Nerradia/SLABoard/BOM_excel.xlsx

Généré par KiCad |  |  | RS |  |  | Farnell
Valeur | Nombre | Références | Prix TTC pièce | Quantité par paquet | Référence RS | Prix TTC pièce | Quantité par paquet | Référence RS | Quantité à commander | Prix commande
100n | 2 | C19 C21 | 0.0348 | 125 | 264-4191 |  |  |  | 125 | 4.35 | ,
220n | 20 | C1 C2 C3 C7 C8 C9 C10 C11 C12 C13 C14 C15 C16 C22 C23 C24 C25 C26 C27 C28 | 0.0492 | 25 | 1886344 |  |  |  | 25 | 1.23 | ,
10u | 4 | C5 C6 C18 C20 | 0.416 | 10 | 7900613 |  |  |  | 10 | 4.16 | ,
220u | 2 | C4 C17 | 0.0804 | 50 | 7111097 |  |  |  | 50 | 4.02 | ,
DIODE | 2 | D1 D2 |  |  |  |  |  |  | 0 | 0
INDUCTOR | 4 | L1 L2 L3 L4 | 0.323 | 10 | 786-7175 |  |  |  | 10 | 3.23 | ,
FDS6898A | 2 | Q1 Q2 | 0.994 | 5 | 8648701 |  |  |  | 5 | 4.97 | ,
DMG3420U | 3 | Q3 Q4 Q5 | 0.0516 | 50 | 7514092 |  |  |  | 50 | 2.58 | ,
100 | 1 | R2 | 0.0108 | 50 | 2232120 |  |  |  | 50 | 0.54 | ,
374 | 4 | R6 R7 R8 R9 | 0.84 | 5 | 828-0976 |  |  |  | 5 | 4.2 | ,
750 | 4 | R11 R12 R13 R14 | 0.226 | 5 | 6696540 |  |  |  | 5 | 1.13 | ,
1,3k | 4 | Val alternative pour R11 R12 R13 R14 | 0.23 | 5 | 8280885 |  |  |  | 5 | 1.15 | ,
1k | 5 | R15 R16 R18 R20 R22 | 0.0096 | 100 | 9013724 |  |  |  | 100 | 0.96
10k | 9 | R1 R3 R4 R5 R10 R24 R25 R26 R32 | 0.0096 | 100 | 9013733 |  |  |  | 100 | 0.96
SPEAKER | 1 | SP1 |  |  |  |  |  |  | 0 | 0
TEENSY3.6 | 1 | U1 |  |  |  |  |  |  | 0 | 0
LM5106 | 2 | U2 U3 | 1.756 | 5 | 651-2789 | 1.848 | 1 | 1312793 | 3 | 5.544 | ,
AD1852 | 1 | U6 | 15.47 | 1 | 709-5614 |  |  |  | 1 | 15.47 | ,
TMC2100 | 1 | U7 |  |  |  |  |  |  | 0 | 0
OPA1632 | 2 | U8 U9 | 6.48 | 1 | 619-9875 |  |  |  | 2 | 12.96 | ,
 | 1 | Lunettes de sécurité |  |  |  | 7.2 | 1 | 1555620 | 1 | 7.2 | ,
 | 1 | Lunettes UV | 13.55 | 1 | 7258102 |  |  |  | 1 | 13.55 | ,
 | 1 | Alcool Isopropylique 1L |  |  |  | 21.024 | 1 | 106970 | 1 | 21.024 | ,
2.2n | 4 | C1 C2 C12 C13 | 0.018 | 100 | 8392940 |  |  |  | 100 | 1.8 | ,
22n | 1 | C4 | 0.0084 | 100 | 7980329 |  |  |  | 100 | 0.84 | ,
100n | 4 | C7 C8 C9 C10 | 0.0084 | 100 | 6983320 |  |  |  | 100 | 0.84 | ,
2.2u | 3 | C3 C5 C6 | 0.0936 | 50 | 8151358 |  |  |  | 50 | 4.68 | ,
4.7u | 4 | C11 C14 C15 C16 | 0.12 | 20 | 9159173 |  |  |  | 20 | 2.4 | ,
CAPAPOL | 3 | C17 C18 C19 | 0.15 | 10 | 756-7825 |  |  |  | 10 | 1.5 | ,
NTMFS1935N | 6 | Q1 Q2 Q3 Q4 Q5 Q6 | 0.455 | 10 | 7804711 |  |  |  | 20 | 9.1 | ,
20m | 2 | R13 R9 | 0.384 | 5 | 566569 |  |  |  | 5 | 1.92 | ,
5.1 | 6 | R6 R7 R10 R11 R14 R15 | 0.031 | 10 | 794-4092 |  |  |  | 10 | 0.31 | ,
56 | 4 | R3 R4 R8 R12 | 0.018 | 50 | 679-0550 |  |  |  | 50 | 0.9 | ,
10k | 2 | R1 R2 | 0.0204 | 50 | 7408805 |  |  |  | 50 | 1.02 | ,
18k | 1 | R5 | 0.024 | 50 | 6789857 |  |  |  | 50 | 1.2 | ,
DRV8301 | 1 | U1 | 6.6 | 1 | 8136466 | 7.92 | 1 | 2057084 | 1 | 7.92 | ,
 |  |  |  |  |  |  |  |  | Total Farnell | 41.688
 |  |  |  |  |  |  |  |  | Total RS | 101.97
 |  |  |  |  |  |  |  |  |  | 143.658
 |  |  |  |  |  |  |  |  | Total | 143.658
