Nerradia/SLABoard/projetcarteslav1.kicad_pcb

## KiCad design projetcarteslav1.kicad_pcb (2017-08-12)

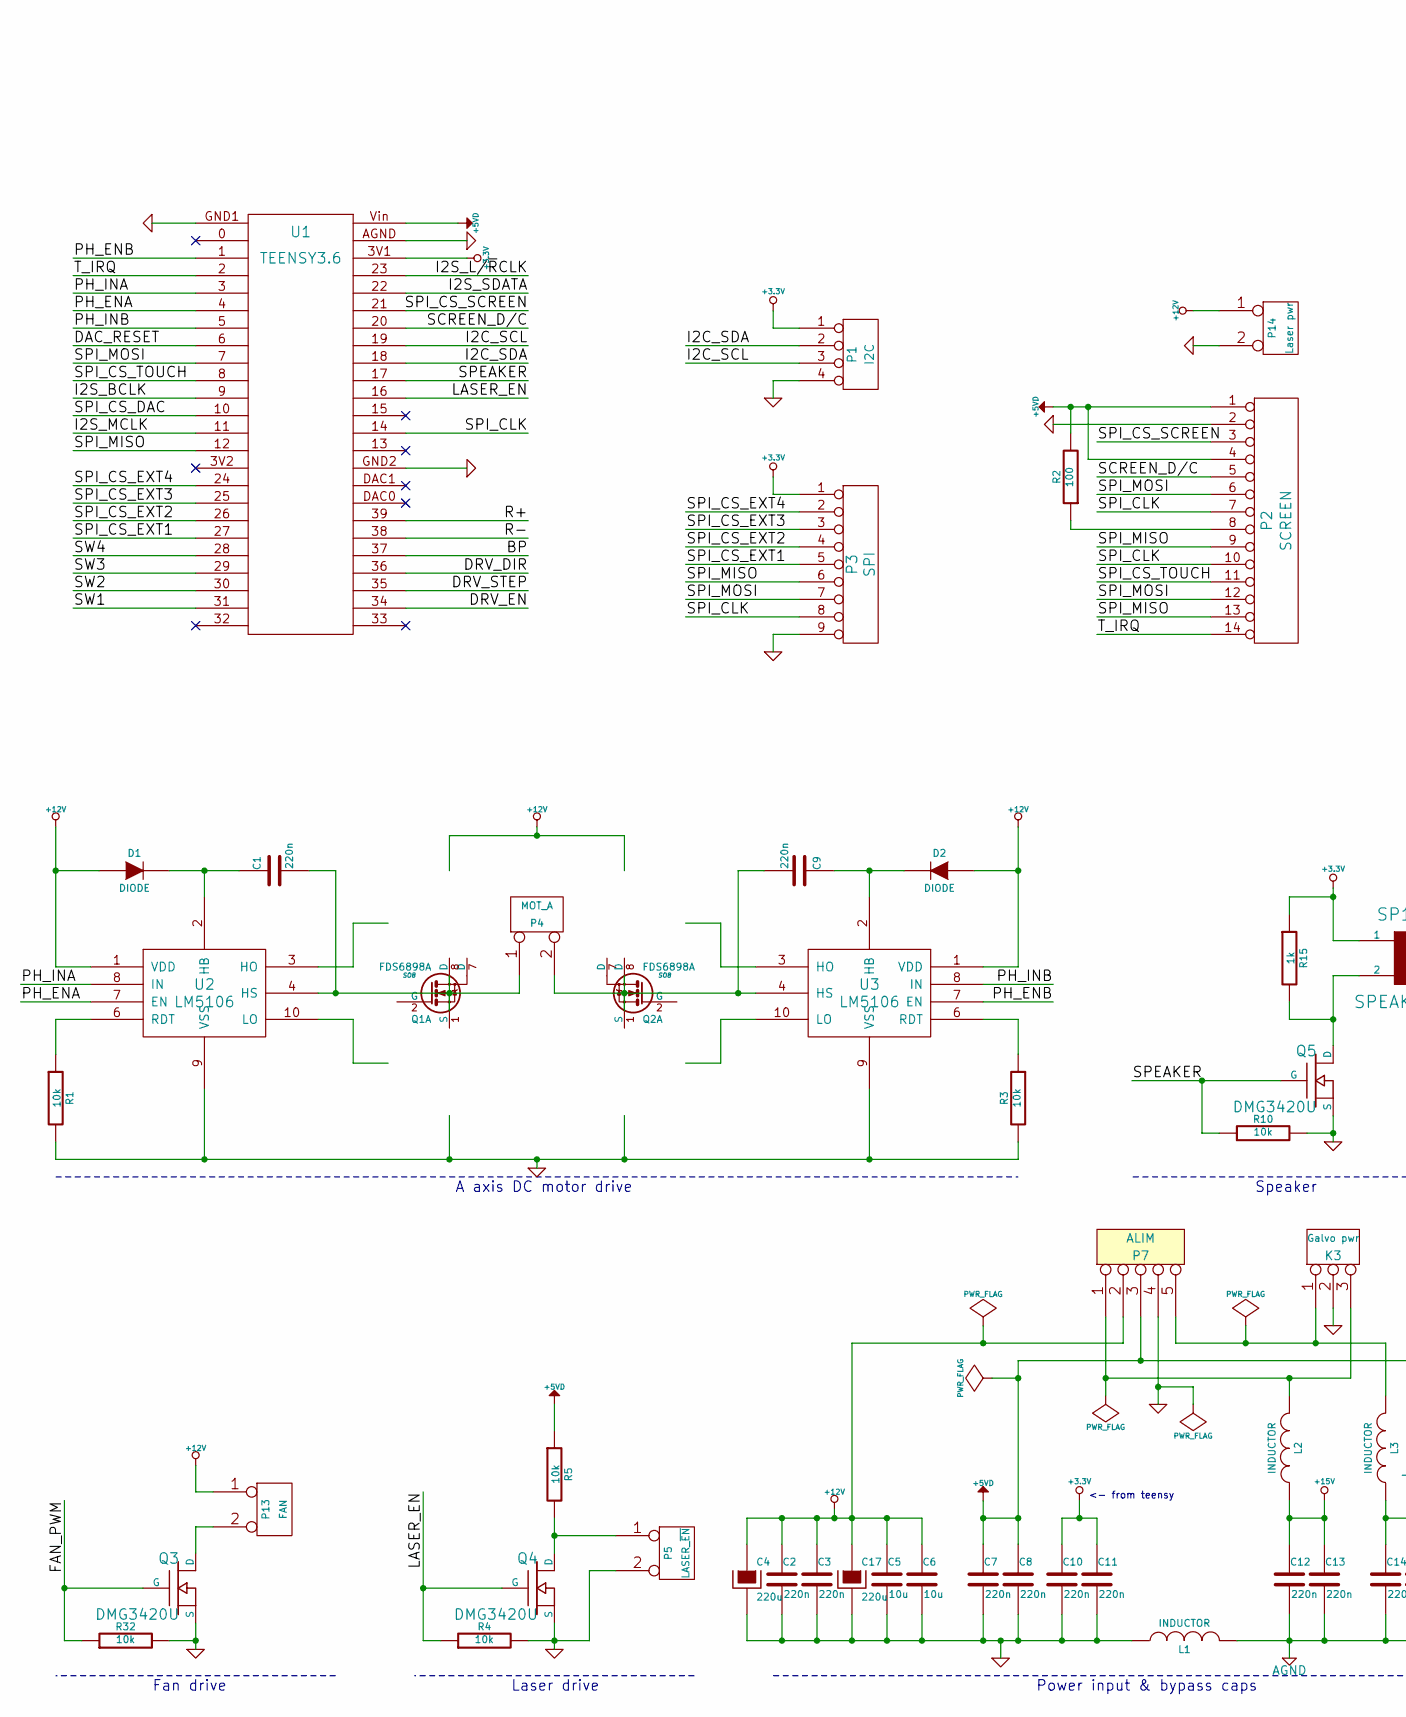
[picture p1: schematic projetcarteslav1.sch, part in row 1, column 1]

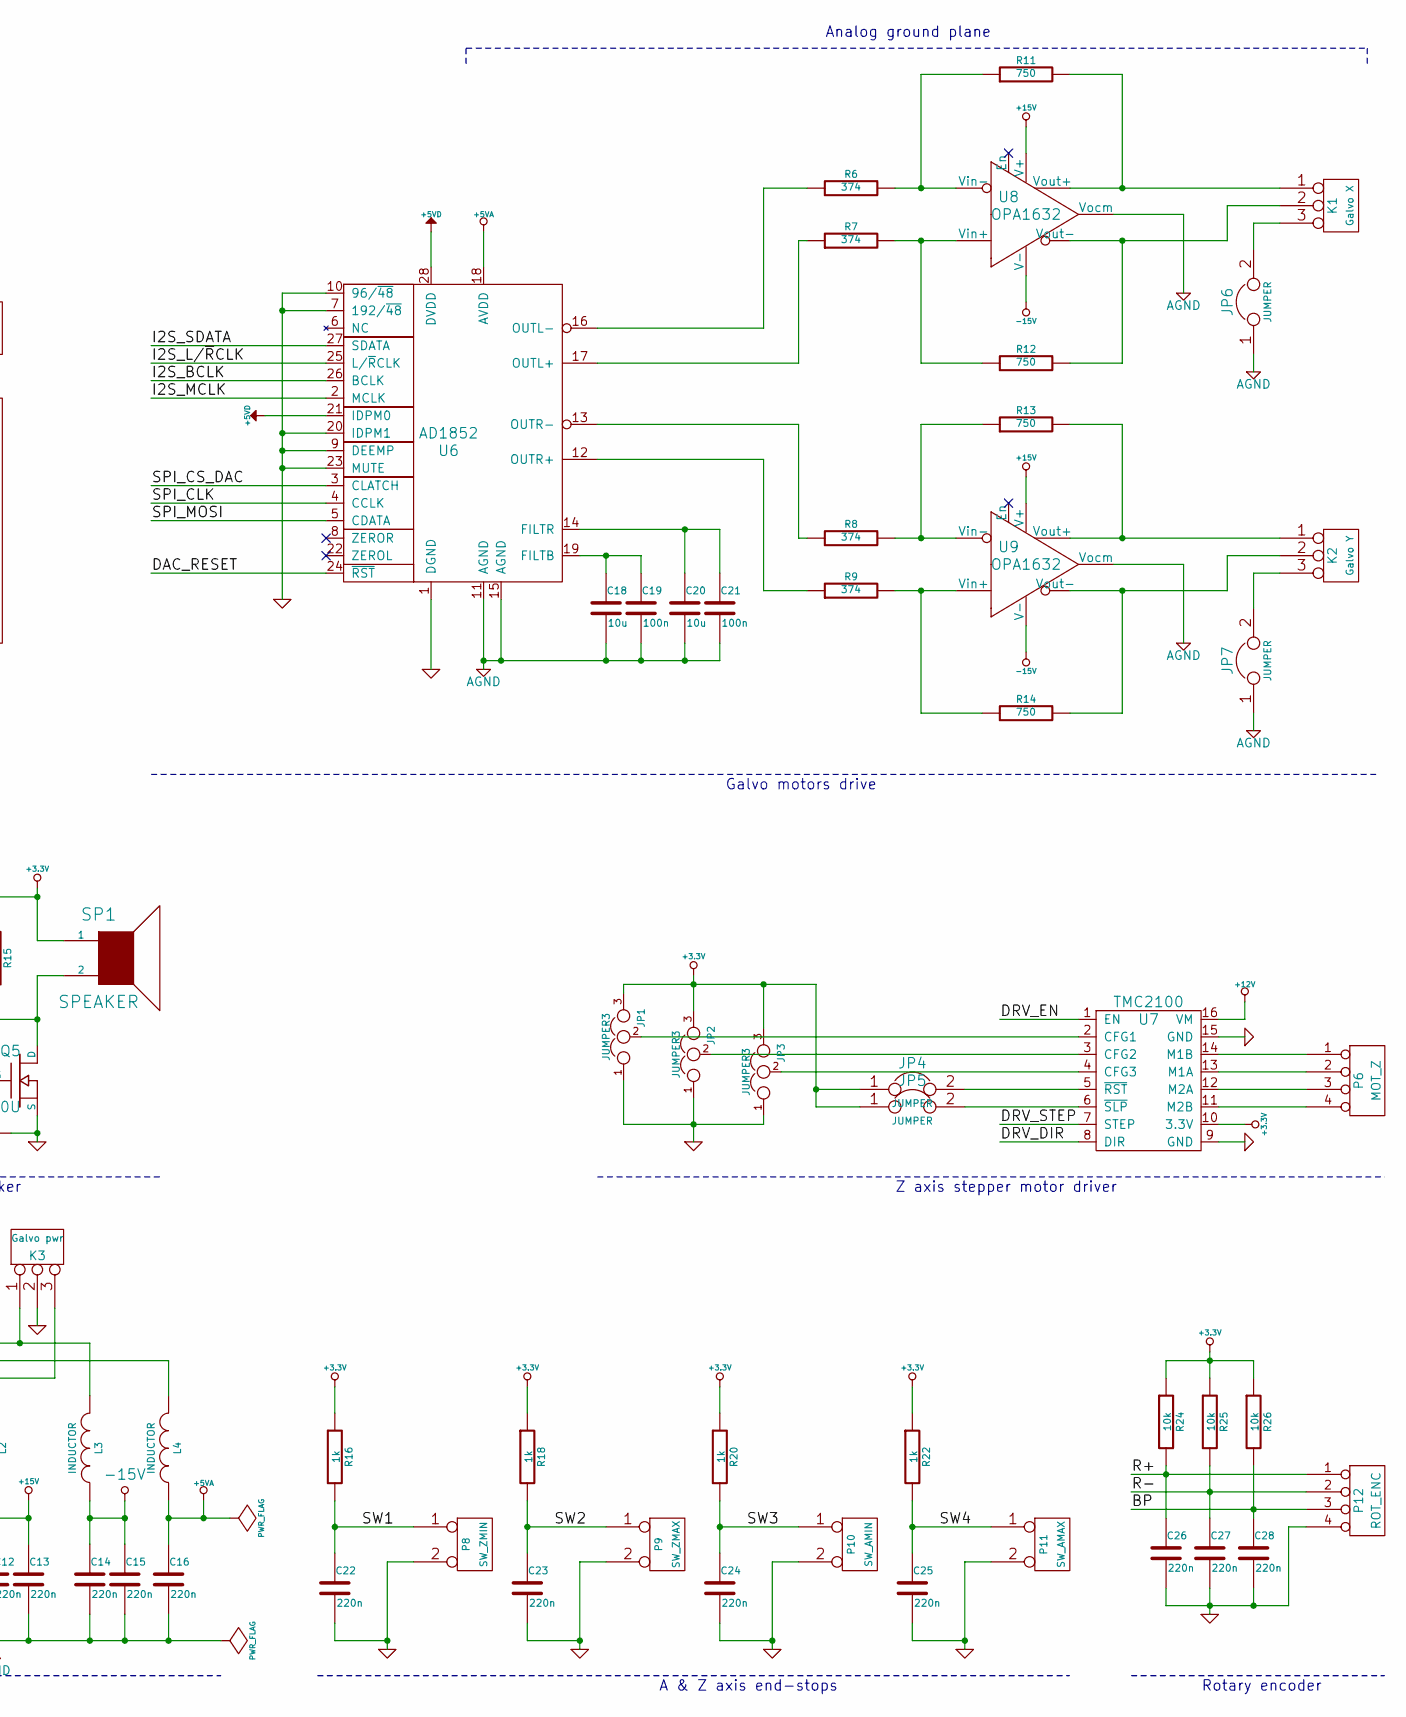
[picture p2: schematic projetcarteslav1.sch, part in row 1, column 2]

Parts:
C1, C2, C3, C7, C8, C9, C10, C11, C12, C13, C14, C15, C16, C22, C23, C24, C25, C26, C27, C28: 220n
C4, C17: 220u
C5, C6, C18, C20: 10u
C19, C21: 100n
D1, D2: DIODE
JP1, JP2, JP3: JUMPER3
JP4, JP5, JP6, JP7: JUMPER
K1: Galvo X
K2: Galvo Y
K3: Galvo pwr
L1, L2, L3, L4: INDUCTOR
P1: I2C
P2: SCREEN
P3: SPI
P4: MOT_A
P5: LASER_~EN
P6: MOT_Z
P7: ALIM
P8: SW_ZMIN
P9: SW_ZMAX
P10: SW_AMIN
P11: SW_AMAX
P12: ROT_ENC
P13: FAN
P14: Laser pwr
Q1, Q2: FDS6898A; SO8
Q3, Q4, Q5: DMG3420U
R1, R3, R4, R5, R10, R24, R25, R26, R32: 10k
R2: 100
R6, R7, R8, R9: 374
R11, R12, R13, R14: 750
R15, R16, R18, R20, R22: 1k
SP1: SPEAKER
U1: TEENSY3.6
U2, U3: LM5106
U6: AD1852
U7: TMC2100
U8, U9: OPA1632

Connections:
+3.3V: C10.1, C11.1, JP1.3, JP2.3, JP3.3, JP4.1, JP5.1, P1.1, P3.1, R15.1, R16.1, R18.1, R20.1, R22.1, R24.1, R25.1, R26.1, SP1.1, U1.3V1 (3.3V_out), U7.10 (3.3V)
+5VA: C16.1, L4.1, U6.18 (AVDD)
+5VD: C7.1, C8.1, L4.2, P2.1, P2.4, P7.3, R2.2, R5.1, U1.Vin, U6.21 (IDPM0), U6.28 (DVDD)
+12V: C2.1, C3.1, C4.1, C5.1, C6.1, C17.1, D1.1 (A), D2.1 (A), P7.2, P13.1, P14.1, Q1.5 (D), Q1.6 (D), Q2.5 (D), Q2.6 (D), U2.1 (VDD), U3.1 (VDD), U7.16 (VM)
+15V: C12.1, C13.1, L2.1, U8.3 (V+), U9.3 (V+)
-15V: C14.1, C15.1, L3.1, U8.6 (V-), U9.6 (V-)
/BP: C28.1, P12.3, R26.2, U1.37
/DAC_RESET: U1.6, U6.24 (~RST)
/DRV_DIR: U1.36, U7.8 (DIR)
/DRV_EN: U1.34, U7.1 (EN)
/DRV_STEP: U1.35, U7.7 (STEP)
/FAN_PWM: Q3.G, R32.1
/I2C_SCL: P1.3, U1.19
/I2C_SDA: P1.2, U1.18
/I2S_BCLK: U1.9, U6.26 (BCLK)
/I2S_L/~R~CLK: U1.23, U6.25 (L/~R~CLK)
/I2S_MCLK: U1.11, U6.2 (MCLK)
/I2S_SDATA: U1.22, U6.27 (SDATA)
/LASER_EN: Q4.G, R4.1, U1.16
/PH_ENA: U1.4, U2.7 (EN)
/PH_ENB: U1.1, U3.7 (EN)
/PH_INA: U1.3, U2.8 (IN)
/PH_INB: U1.5, U3.8 (IN)
/R+: C26.1, P12.1, R24.2, U1.39
/R-: C27.1, P12.2, R25.2, U1.38
/SCREEN_D/C: P2.5, U1.20
/SPEAKER: Q5.G, R10.1, U1.17
/SPI_CLK: P2.7, P2.10, P3.8, U1.14, U6.4 (CCLK)
/SPI_CS_DAC: U1.10, U6.3 (CLATCH)
/SPI_CS_EXT1: P3.5, U1.27
/SPI_CS_EXT2: P3.4, U1.26
/SPI_CS_EXT3: P3.3, U1.25
/SPI_CS_EXT4: P3.2, U1.24
/SPI_CS_SCREEN: P2.3, U1.21
/SPI_CS_TOUCH: P2.11, U1.8
/SPI_MISO: P2.9, P2.13, P3.6, U1.12
/SPI_MOSI: P2.6, P2.12, P3.7, U1.7, U6.5 (CDATA)
/SW1: C22.1, P8.1, R16.2, U1.31
/SW2: C23.1, P9.1, R18.2, U1.30
/SW3: C24.1, P10.1, R20.2, U1.29
/SW4: C25.1, P11.1, R22.2, U1.28
/T_IRQ: P2.14, U1.2
AGND: C12.2, C13.2, C14.2, C15.2, C16.2, C18.2, C19.2, C20.2, C21.2, JP6.1, JP7.1, L1.2, U6.11 (AGND), U6.15 (AGND), U8.2 (Vocm), U9.2 (Vocm)
GND: C2.2, C3.2, C4.2, C5.2, C6.2, C7.2, C8.2, C10.2, C11.2, C17.2, C22.2, C23.2, C24.2, C25.2, C26.2, C27.2, C28.2, JP1.1, JP2.1, JP3.1, K3.2 (PM), L1.1, P1.4, P2.2, P3.9, P5.2 (PM), P7.4, P8.2 (PM), P9.2 (PM), P10.2 (PM), P11.2 (PM), P12.4, P14.2 (PM), Q1.1 (S), Q2.1 (S), Q3.S, Q4.S, Q5.S, R1.2, R3.2, R4.2, R10.2, R32.2, U1.AGND (Analog_GND), U1.GND1 (GND), U1.GND2 (GND), U2.9 (VSS), U3.9 (VSS), U6.1 (DGND), U6.7 (192/~48), U6.9 (DEEMP), U6.10 (96/~48), U6.20 (IDPM1), U6.23 (MUTE), U7.9 (GND), U7.15 (GND)
unnamed: K3.3, L2.2, P7.1
unnamed: P5.1, Q4.D, R5.2
unnamed: R7.1, U6.17 (OUTL+)
unnamed: R8.1, U6.13 (OUTR-)
unnamed: K1.1, R11.2, U8.4 (Vout+)
unnamed: R6.2, R11.1, U8.1 (Vin-)
unnamed: C18.1, C19.1, U6.19 (FILTB)
unnamed: R9.1, U6.12 (OUTR+)
unnamed: K2.2 (PM), R14.2, U9.5 (Vout-)
unnamed: R9.2, R14.1, U9.8 (Vin+)
unnamed: R6.1, U6.16 (OUTL-)
unnamed: R8.2, R13.1, U9.1 (Vin-)
unnamed: K2.1, R13.2, U9.4 (Vout+)
unnamed: R7.2, R12.1, U8.8 (Vin+)
unnamed: JP7.2, K2.3
unnamed: Q5.D, R15.2, SP1.2
unnamed: C20.1, C21.1, U6.14 (FILTR)
unnamed: K1.2 (PM), R12.2, U8.5 (Vout-)
unnamed: JP6.2, K1.3
unnamed: P13.2 (PM), Q3.D
unnamed: K3.1, L3.2, P7.5
unnamed: P2.8, R2.1
unnamed: P6.1, U7.14 (M1B)
unnamed: Q1.4 (G), U2.3 (HO)
unnamed: C1.1, D1.2 (K), U2.2 (HB)
unnamed: Q1.2 (G), U2.10 (LO)
unnamed: JP1.2, U7.2 (CFG1)
unnamed: JP2.2, U7.3 (CFG2)
unnamed: JP3.2, U7.4 (CFG3)
unnamed: JP4.2, U7.5 (~RST)
unnamed: JP5.2, U7.6 (~SLP)
unnamed: P6.4, U7.11 (M2B)
unnamed: P6.3, U7.12 (M2A)
unnamed: P6.2, U7.13 (M1A)
unnamed: R1.1, U2.6 (RDT)
unnamed: C9.1, D2.2 (K), U3.2 (HB)
unnamed: R3.1, U3.6 (RDT)
unnamed: Q2.2 (G), U3.10 (LO)
unnamed: Q2.4 (G), U3.3 (HO)

Notes on the sheet:
<- from teensy
Analog ground plane
A & Z axis end-stops
Galvo motors drive
A axis DC motor drive
Z axis stepper motor driver
Laser drive
Rotary encoder
Power input & bypass caps
Speaker
Fan drive

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
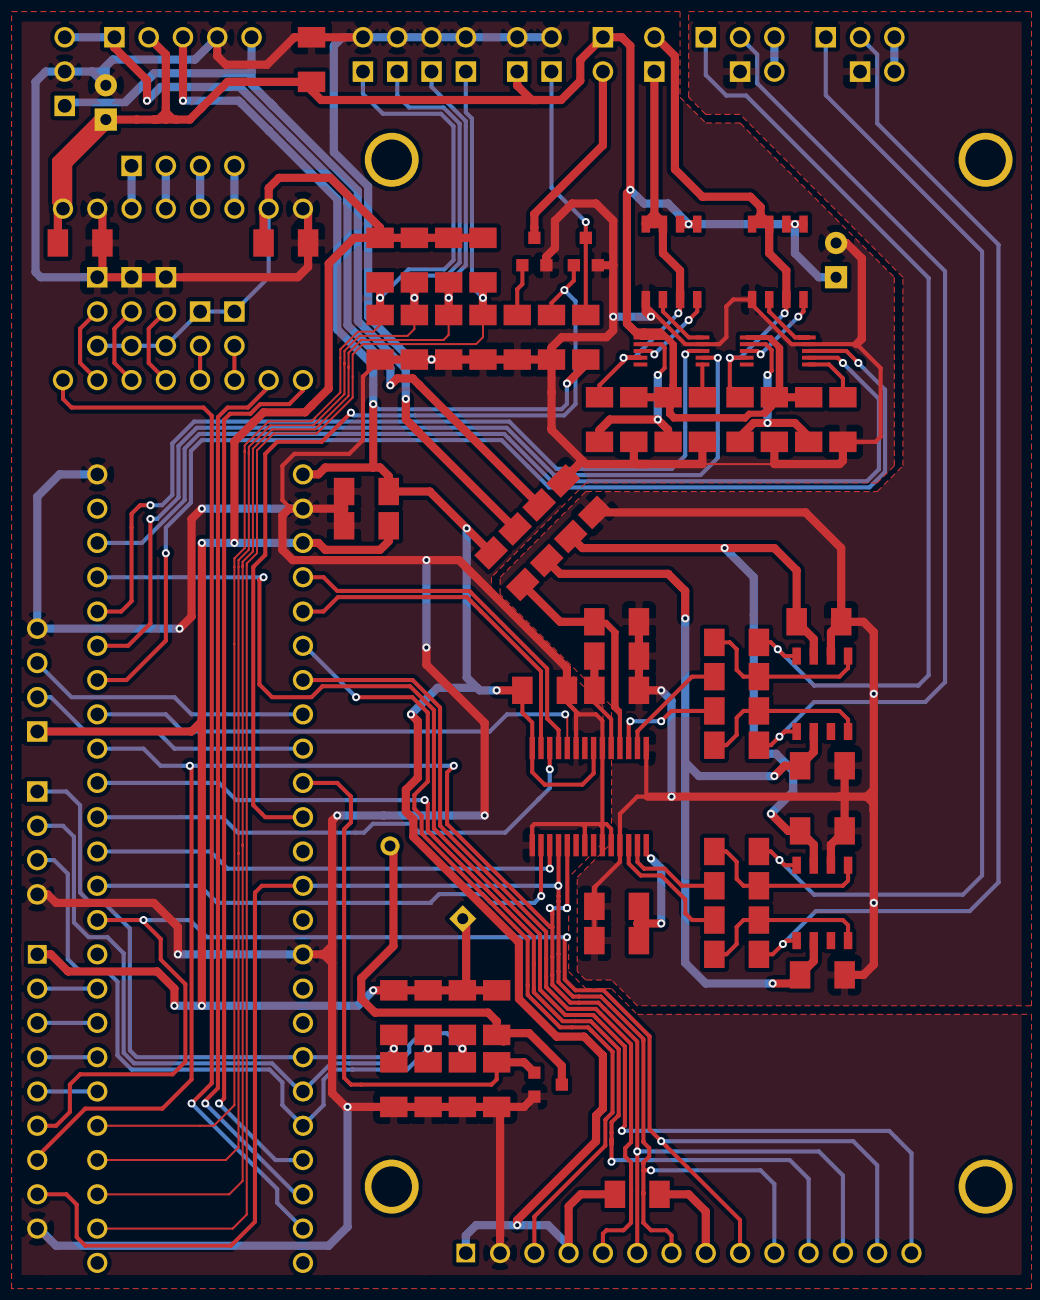
[picture p3: board projetcarteslav1.kicad_pcb from above]

Board: 2 copper layers, 95 parts (0 on the bottom side), 85 nets.

Other parts of the board:
svg2mod-rev: G***; svg2mod-rev
