Nerradia/SLABoard/(threads)

Thread 1 (2022-02-12):

please support

Haiang, 2022-02-12:
please support
Board design issues
