Nerradia/SLABoard/(commit log)

2017-08-12 Fixed C5 silkscreen, fixed shorts of speaker terminals.
    [projetcarteslav1.kicad_pcb]
2017-09-08 Creation of BOM
    [BOM_excel.xlsx]
2017-09-09 progress on BOM
    [BOM_excel.xlsx]
2017-09-21 received components
    [BOM_excel.xlsx]
